mason3263/capstone-kicad/production/OrderFiles/bom-JLCPCB Assembly Order.xls

JLCPCB BOM Tool - BOM Matching
BOM name：bom-JLCPCB Assembly Order.xlsx |  |  | Download Time：2026-02-20 00:51:47 |  |  |  | * Our matching results are updated in real-time, but stock and prices may change. If it's been over 24 hours, please re-match before placing your order.
PCB Assembled Qty：5 |  |  | Est. Total Price：26.3321
Your BOM |  |  |  |  | Matched Parts |  |  |  |  |  |  | Order Information
Top Designator | Bottom Designator | Comment | Footprint | JLCPCB Part # | Matches | Part # | Manufacturer | Footprint | Description | Category | Warning | JLCPCB Part # | Product link | Lib Type | Qty | Source | Total Price ($)
AE1 |  | Antenna | Johanson_2450AT18x100 |  | Select by Customer | 2450AT18A100E | Johanson Dielectrics | 1206 | -40℃~+125℃ 0.5dBi 1.3mm 1.6mm 2.4GHz 2W 3.2mm 50Ω SMA 1206 Antennas ROHS | Antennas |  | C89334 | https://jlcpcb.com/partdetail/JohansonDielectrics-2450AT18A100E/C89334 | Extended | 5 | 5 JLCPCB | 2.884
C1,C10,C2,C20,C21,C3,C5,C7,C8,C9 | C17 | 100nF | 0603 |  | Select by System | CC0603KRX7R9BB104 | YAGEO | 0603 | 100nF 50V X7R ±10% 0603 Multilayer Ceramic Capacitors MLCC - SMD/SMT ROHS | Multilayer Ceramic Capacitors MLCC - SMD/SMT |  | C14663 | https://jlcpcb.com/partdetail/YAGEO-CC0603KRX7R9BB104/C14663 | Basic | 50 | 50 JLCPCB | 0.13
C4,C6 |  | 22uF | 0603 |  | Select by System | CL10A226MQ8NRNC | Samsung Electro-Mechanics | 0603 | 22uF 6.3V X5R ±20% 0603 Multilayer Ceramic Capacitors MLCC - SMD/SMT ROHS | Multilayer Ceramic Capacitors MLCC - SMD/SMT |  | C59461 | https://jlcpcb.com/partdetail/60514-CL10A226MQ8NRNC/C59461 | Basic | 10 | 10 JLCPCB | 0.094
C11,C12,C13,C14 |  | 10pF | 0603 |  | Select by System | CL10C100JB8NNNC | Samsung Electro-Mechanics | 0603 | 10pF 50V C0G ±5% 0603 Multilayer Ceramic Capacitors MLCC - SMD/SMT ROHS | Multilayer Ceramic Capacitors MLCC - SMD/SMT |  | C1634 | https://jlcpcb.com/partdetail/1986-CL10C100JB8NNNC/C1634 | Basic | 20 | 20 JLCPCB | 0.098
C19 |  | 200nF | 0603 |  | Select by System | 0603B204K160CT | Walsin Tech Corp | 0603 | 16V 200nF X7R ±10% 0603 Multilayer Ceramic Capacitors MLCC - SMD/SMT ROHS | Multilayer Ceramic Capacitors MLCC - SMD/SMT |  | C3833176 | https://jlcpcb.com/partdetail/Walsin_TechCorp-0603B204K160CT/C3833176 | Extended | 20 | 20 JLCPCB | 0.706
C22,C25,C31 |  | 2.2uF | 0603 |  | Select by System | CL10A225KO8NNNC | Samsung Electro-Mechanics | 0603 | 16V 2.2uF X5R ±10% 0603 Multilayer Ceramic Capacitors MLCC - SMD/SMT ROHS | Multilayer Ceramic Capacitors MLCC - SMD/SMT |  | C23630 | https://jlcpcb.com/partdetail/24366-CL10A225KO8NNNC/C23630 | Basic | 15 | 15 JLCPCB | 0.0915
C23,C24 | C15 | 1uF | 0603 |  | Select by System | CL10A105KB8NNNC | Samsung Electro-Mechanics | 0603 | 1uF 50V X5R ±10% 0603 Multilayer Ceramic Capacitors MLCC - SMD/SMT ROHS | Multilayer Ceramic Capacitors MLCC - SMD/SMT |  | C15849 | https://jlcpcb.com/partdetail/16531-CL10A105KB8NNNC/C15849 | Basic | 10 | 10 JLCPCB | 0.056
C26,C28 |  | 47pF | 0603 |  | Select by System | CL10C470JB8NNNC | Samsung Electro-Mechanics | 0603 | 47pF 50V C0G ±5% 0603 Multilayer Ceramic Capacitors MLCC - SMD/SMT ROHS | Multilayer Ceramic Capacitors MLCC - SMD/SMT |  | C1671 | https://jlcpcb.com/partdetail/2023-CL10C470JB8NNNC/C1671 | Basic | 10 | 10 JLCPCB | 0.032
C27,C29 | C16,C18 | 10uF | 0603 |  | Select by System | CL10A106KP8NNNC | Samsung Electro-Mechanics | 0603 | 10V 10uF X5R ±10% 0603 Multilayer Ceramic Capacitors MLCC - SMD/SMT ROHS | Multilayer Ceramic Capacitors MLCC - SMD/SMT |  | C19702 | https://jlcpcb.com/partdetail/20411-CL10A106KP8NNNC/C19702 | Basic | 10 | 10 JLCPCB | 0.065
C30 |  | 4.7uF | 0603 |  | Select by System | CL10A475KO8NNNC | Samsung Electro-Mechanics | 0603 | 16V 4.7uF X5R ±10% 0603 Multilayer Ceramic Capacitors MLCC - SMD/SMT ROHS | Multilayer Ceramic Capacitors MLCC - SMD/SMT |  | C19666 | https://jlcpcb.com/partdetail/20375-CL10A475KO8NNNC/C19666 | Basic | 5 | 5 JLCPCB | 0.0515
C32 |  | 1pF | 0603 |  | Select by System | 0603CG1R0C500NT | FH (Guangdong Fenghua Advanced Tech) | 0603 | 1pF 50V C0G 0603 Multilayer Ceramic Capacitors MLCC - SMD/SMT ROHS | Multilayer Ceramic Capacitors MLCC - SMD/SMT |  | C37117 | https://jlcpcb.com/partdetail/38096-0603CG1R0C500NT/C37117 | Extended | 20 | 20 JLCPCB | 0.072
CX2016FB-1 |  | 48MHz | Crystal_SMD_2016-4Pin_2.0x1.6mm |  | Select by Customer | NX2016SA-48MHZ-EXS00A-CS05517 | NDK | SMD2016-4P | -40℃~+105℃ 40Ω 48MHz 7pF Crystal Oscillator ±10ppm ±40ppm SMD2016-4P Crystals ROHS | Global Sourcing Parts |  | C5186571 | https://jlcpcb.com/partdetail/NDK-NX2016SA_48MHZ_EXS00ACS05517/C5186571 | Extended | 5 | 5 JLCPCB | 1.9595
J1 |  | USBC | MOLEX_USBC_1054500101 |  | Select by Customer | 1054500101 | MOLEX | SMD | -30℃~+85℃ 1 10,000 cycles 24P 30V Black Female Type-C USB 3.2 SMD USB Connectors ROHS | USB Connectors |  | C134092 | https://jlcpcb.com/partdetail/MOLEX-1054500101/C134092 | Extended | 5 | 5 JLCPCB | 5.2695
L1,L2 |  | 2.2uH | 1008 |  | Select by Customer | SWPA252012S2R2MT | Sunlord | 1008 | 1.25A 2.07A 2.2uH 216mΩ ±20% 1008 Power Inductors ROHS | Power Inductors |  | C23894 | https://jlcpcb.com/partdetail/Sunlord-SWPA252012S2R2MT/C23894 | Extended | 14 | 14 JLCPCB | 0.6356
L3 |  | 3.9nH | 0603 |  | Select by System | SDCL1608C3N9STDF | Sunlord | 0603 | 10@100MHz 160mΩ 3.9nH 500mA 6GHz Multilayer inductor 0603 Inductors (SMD) ROHS | Inductors (SMD) |  | C13818 | https://jlcpcb.com/partdetail/Sunlord-SDCL1608C3N9STDF/C13818 | Extended | 20 | 20 JLCPCB | 0.27
L4 |  | 2.7nH | 0603 |  | Select by System | SCC1608C2N7SSP | Sunltech Tech | 0603 | 2.7nH 200mΩ 500mA 6GHz 8@100MHz Multilayer inductor 0603 Inductors (SMD) ROHS | Inductors (SMD) |  | C412027 | https://jlcpcb.com/partdetail/SunltechTech-SCC1608C2N7SSP/C412027 | Extended | 20 | 20 JLCPCB | 0.244
NX2012SA-1 |  | 32.768kHz | Crystal_SMD_2012-2Pin_2.0x1.2mm |  | Select by Customer | NX2012SA-32.768KHZ-STD-MUB-2 | NDK | SMD2012-2P | -40℃~+85℃ 32.768kHz Crystal Oscillator SMD2012-2P Crystals ROHS | Crystals |  | C891748 | https://jlcpcb.com/partdetail/NDK-NX2012SA_32_768KHZ_STD_MUB2/C891748 | Extended | 5 | 5 JLCPCB | 1.845
R1 |  | 100k | 0603 |  | Unconfirmed | 0603WAF1003T5E | UNI-ROYAL(Uniroyal Elec) | 0603 | -55℃~+155℃ 100kΩ 100mW 75V Thick Film Resistor ±1% ±100ppm/℃ 0603 Chip Resistor - Surface Mount ROHS | Chip Resistor - Surface Mount | 1.The comment (0603WAF1003T5E) of this part does not match the one (100k) provided in your BOM. Please confirm; | C25803 | https://jlcpcb.com/partdetail/26546-0603WAF1003T5E/C25803 | Basic | 5 | 5 JLCPCB | 0.0055
R2 |  | 680k | 0603 |  | Unconfirmed | 0603WAF6803T5E | UNI-ROYAL(Uniroyal Elec) | 0603 | -55℃~+155℃ 100mW 680kΩ 75V Thick Film Resistor ±1% ±100ppm/℃ 0603 Chip Resistor - Surface Mount ROHS | Chip Resistor - Surface Mount | 1.The comment (0603WAF6803T5E) of this part does not match the one (680k) provided in your BOM. Please confirm; | C25822 | https://jlcpcb.com/partdetail/26565-0603WAF6803T5E/C25822 | Extended | 20 | 20 JLCPCB | 0.024
R3,R5 |  | 150k | 0603 |  | Unconfirmed | 0603WAF1503T5E | UNI-ROYAL(Uniroyal Elec) | 0603 | -55℃~+155℃ 100mW 150kΩ 75V Thick Film Resistor ±1% ±100ppm/℃ 0603 Chip Resistor - Surface Mount ROHS | Chip Resistor - Surface Mount | 1.The comment (0603WAF1503T5E) of this part does not match the one (150k) provided in your BOM. Please confirm; | C22807 | https://jlcpcb.com/partdetail/23534-0603WAF1503T5E/C22807 | Basic | 10 | 10 JLCPCB | 0.013
R4 |  | 350k | 0603 |  | Unconfirmed | AR03FTDX3503N | Viking Tech | 0603 | -55℃~+155℃ 100mW 350kΩ Thin Film Resistor ±1% ±50ppm/℃ 0603 Chip Resistor - Surface Mount ROHS | Chip Resistor - Surface Mount | 1.The comment (AR03FTDX3503N) of this part does not match the one (350k) provided in your BOM. Please confirm; | C3013581 | https://jlcpcb.com/partdetail/VikingTech-AR03FTDX3503N/C3013581 | Extended | 20 | 20 JLCPCB | 0.186
R6 |  | 240k | 0603 |  | Unconfirmed | 0603WAF2403T5E | UNI-ROYAL(Uniroyal Elec) | 0603 | -55℃~+155℃ 100mW 240kΩ 75V Thick Film Resistor ±1% ±100ppm/℃ 0603 Chip Resistor - Surface Mount ROHS | Chip Resistor - Surface Mount | 1.The comment (0603WAF2403T5E) of this part does not match the one (240k) provided in your BOM. Please confirm; | C4197 | https://jlcpcb.com/partdetail/4604-0603WAF2403T5E/C4197 | Extended | 20 | 20 JLCPCB | 0.024
R8 |  | 27.4k | 0603 |  | Unconfirmed | FRC0603F2742TS | FOJAN | 0603 | -55℃~+155℃ 100mW 27.4kΩ 75V Thick Film Resistor ±1% ±100ppm/℃ 0603 Chip Resistor - Surface Mount ROHS | Chip Resistor - Surface Mount | 1.The comment (FRC0603F2742TS) of this part does not match the one (27.4k) provided in your BOM. Please confirm; | C2933186 | https://jlcpcb.com/partdetail/FOJAN-FRC0603F2742TS/C2933186 | Extended | 20 | 20 JLCPCB | 0.026
R9 |  | 1k | 0603 |  | Unconfirmed | 0603WAF1001T5E | UNI-ROYAL(Uniroyal Elec) | 0603 | -55℃~+155℃ 100mW 1kΩ 75V Thick Film Resistor ±1% ±100ppm/℃ 0603 Chip Resistor - Surface Mount ROHS | Chip Resistor - Surface Mount | 1.The comment (0603WAF1001T5E) of this part does not match the one (1k) provided in your BOM. Please confirm; | C21190 | https://jlcpcb.com/partdetail/21904-0603WAF1001T5E/C21190 | Basic | 5 | 5 JLCPCB | 0.006
R10 |  | 50 | 0603 |  | Unconfirmed | RT0603BRE0750RL | YAGEO | 0603 | -55℃~+155℃ 100mW 50Ω 75V Thin Film Resistor ±0.1% ±50ppm/℃ 0603 Chip Resistor - Surface Mount ROHS | Chip Resistor - Surface Mount | 1.The comment (RT0603BRE0750RL) of this part does not match the one (50) provided in your BOM. Please confirm; | C849792 | https://jlcpcb.com/partdetail/YAGEO-RT0603BRE0750RL/C849792 | Extended | 20 | 20 JLCPCB | 0.554
R11,R13,R7 |  | 10k | 0603 |  | Unconfirmed | 0603WAF1002T5E | UNI-ROYAL(Uniroyal Elec) | 0603 | -55℃~+155℃ 100mW 10kΩ 75V Thick Film Resistor ±1% ±100ppm/℃ 0603 Chip Resistor - Surface Mount ROHS | Chip Resistor - Surface Mount | 1.The comment (0603WAF1002T5E) of this part does not match the one (10k) provided in your BOM. Please confirm; | C25804 | https://jlcpcb.com/partdetail/26547-0603WAF1002T5E/C25804 | Basic | 15 | 15 JLCPCB | 0.018
R12 |  | 300k | 0603 |  | Unconfirmed | 0603WAF3003T5E | UNI-ROYAL(Uniroyal Elec) | 0603 | -55℃~+155℃ 100mW 300kΩ 75V Thick Film Resistor ±1% ±100ppm/℃ 0603 Chip Resistor - Surface Mount ROHS | Chip Resistor - Surface Mount | 1.The comment (0603WAF3003T5E) of this part does not match the one (300k) provided in your BOM. Please confirm; | C23024 | https://jlcpcb.com/partdetail/23751-0603WAF3003T5E/C23024 | Basic | 5 | 5 JLCPCB | 0.0065
U3 |  | BQ25176JDSGR | BQ25176 |  | Select by System | BQ25176JDSGR | Texas Instruments | WSON-8-EP(2x2) | -40℃~+125℃ 1 3V~25V 800mA WSON-8-EP(2x2) Battery Management ROHS | Battery Management |  | C22407142 | https://jlcpcb.com/partdetail/TexasInstruments-BQ25176JDSGR/C22407142 | Extended | 5 | 5 JLCPCB | 5.064
U5 |  | BQ27427YZFR | BQ27427 |  | Select by System | BQ27427YZFR | Texas Instruments | DSBGA-9 | -40℃~+85℃ 1 2.45V~4.5V 50uA I2C Lithium Battery Monitoring IC Support DSBGA-9 Battery Management ROHS | Battery Management |  | C6075475 | https://jlcpcb.com/partdetail/TexasInstruments-BQ27427YZFR/C6075475 | Extended | 5 | 5 JLCPCB | 5.9015
U2 |  | ADXL366BCCZ-RL7 | ADXL366BCCZ-RL7 |  | Select by System | ADXL366BCCZ-RL7 | Analog Devices | - | - LCDH ROHS |  |  | C48940637 | https://jlcpcb.com/partdetail/AnalogDevices-ADXL366BCCZRL7/C48940637 | Extended | 5 | 0 JLCPCB | 0
U4 |  | TPS650531RGER | TPS650531 |  | Select by System | TPS650531RGER | Texas Instruments | VQFN-24-EP(4x4) | -40℃~+85℃ 2.25MHz 2.5V~6V Buck Buck Built-in VQFN-24-EP(4x4) Power Management - Specialized ROHS | DC-DC Converters |  | C527526 | https://jlcpcb.com/partdetail/TexasInstruments-TPS650531RGER/C527526 | Extended | 5 | 0 JLCPCB | 0
J2 |  | Conn_01x02_Pin | PinHeader_1x02_P2.54mm_Vertical |  | No matches | No Part Selected
J3 |  | Conn_01x05 | PinHeader_1x05_P2.54mm_Vertical |  | No matches | No Part Selected
MCU1 |  | CC2674R106T0RGZR | CC2647R106T0RGZR |  | No matches | No Part Selected
P1,P2 |  |  |  |  | No matches | No Part Selected
