mason3263/capstone-kicad/models/FC-135.step

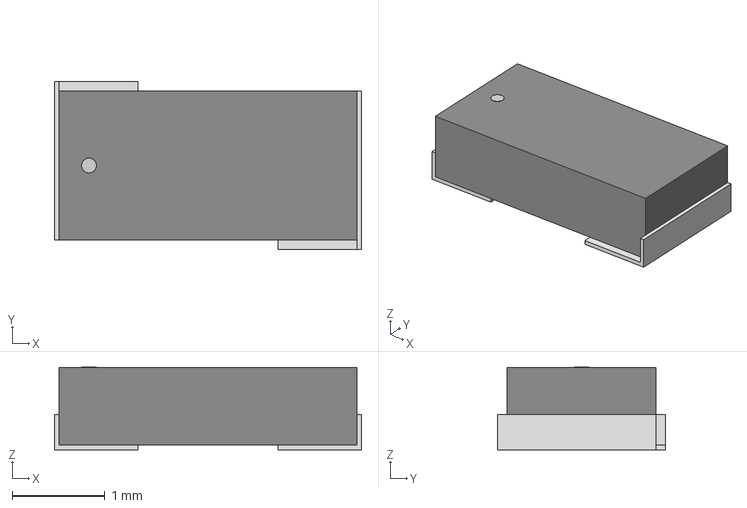
[picture p1: CAD file, 2025-11-21]
models/FC-135.step
3.30 x 1.80 x 0.892 mm
