mason3263/capstone-kicad/models/TSX-3225-24.0000MF15X-AC3.step

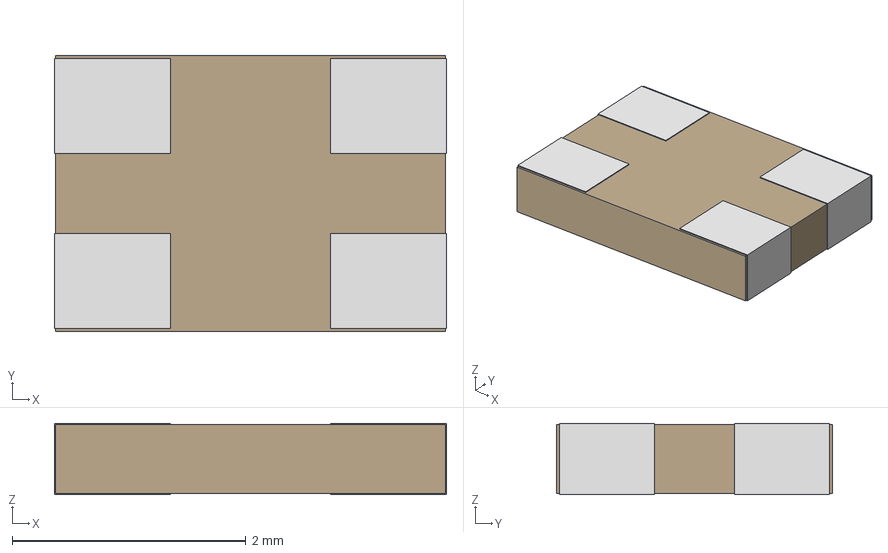
[picture p2: CAD file, 2025-11-21]
models/TSX-3225-24.0000MF15X-AC3.step
3.35 x 2.36 x 0.61 mm
