mason3263/capstone-kicad/health_monitor.kicad_pcb

## KiCad design health_monitor.kicad_pcb (2026-02-24)

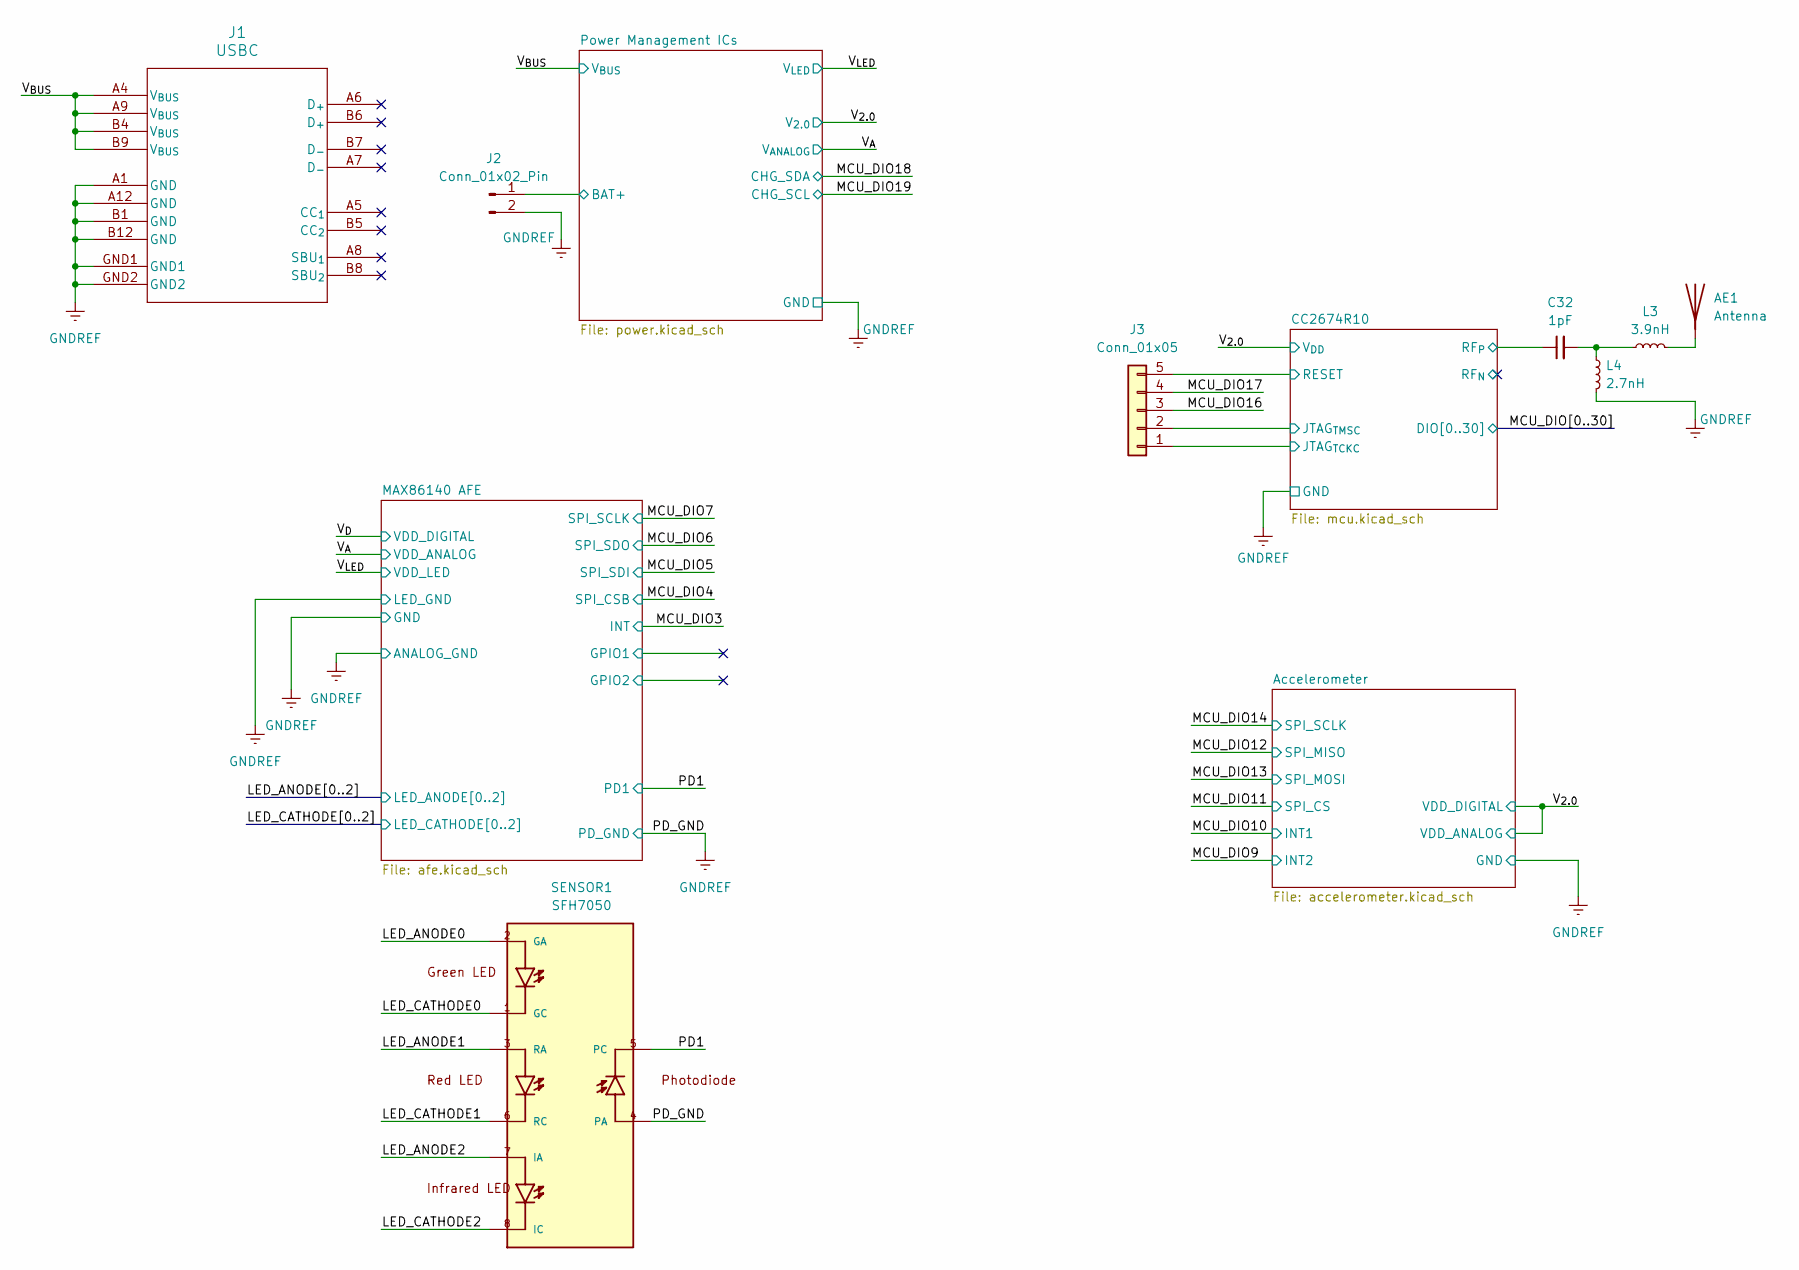
[picture p3: schematic health_monitor.kicad_sch, Wearable Vital Monitor]

Parts:
AE1: Antenna; Johanson_2450AT18x100; LCSC PN C89334
C32: 1pF; C_0603_1608Metric
J1: USBC; MOLEX_USBC_1054500101; LCSC PN C134092
J2: Conn_01x02_Pin; PinHeader_1x02_P2.54mm_Vertical
J3: Conn_01x05; PinHeader_1x05_P2.54mm_Vertical
L3: 3.9nH; L_0603_1608Metric
L4: 2.7nH; L_0603_1608Metric
SENSOR1: SFH7050; SFH 7050A_OSM

Connections:
/CC2674R10/JTAG_{TCKC}: J3.1; also elsewhere on the board
/CC2674R10/JTAG_{TMSC}: J3.2; also elsewhere on the board
/CC2674R10/RESET: J3.5; also elsewhere on the board
/CC2674R10/RF_{P}: C32.1; also elsewhere on the board
/LED_CATHODE0: SENSOR1.1 (GC); also elsewhere on the board
/LED_CATHODE1: SENSOR1.6 (RC); also elsewhere on the board
/LED_CATHODE2: SENSOR1.8 (IC); also elsewhere on the board
/MCU_DIO16: J3.3; also elsewhere on the board
/MCU_DIO17: J3.4; also elsewhere on the board
/PD1: SENSOR1.5 (PC); also elsewhere on the board
/Power Management ICs/BAT+: J2.1; also elsewhere on the board
/V_{BUS}: J1.A4 (V_{BUS}), J1.A9 (V_{BUS}), J1.B4 (V_{BUS}), J1.B9 (V_{BUS}); also elsewhere on the board
/V_{LED}: SENSOR1.2 (GA), SENSOR1.3 (RA), SENSOR1.7 (IA); also elsewhere on the board
GNDREF: J1.A1 (GND), J1.A12 (GND), J1.B1 (GND), J1.B12 (GND), J1.GND1, J1.GND2, J2.2, L4.2, SENSOR1.4 (PA); also elsewhere on the board
unnamed: AE1.1 (A), L3.2
unnamed: C32.2, L3.1, L4.1

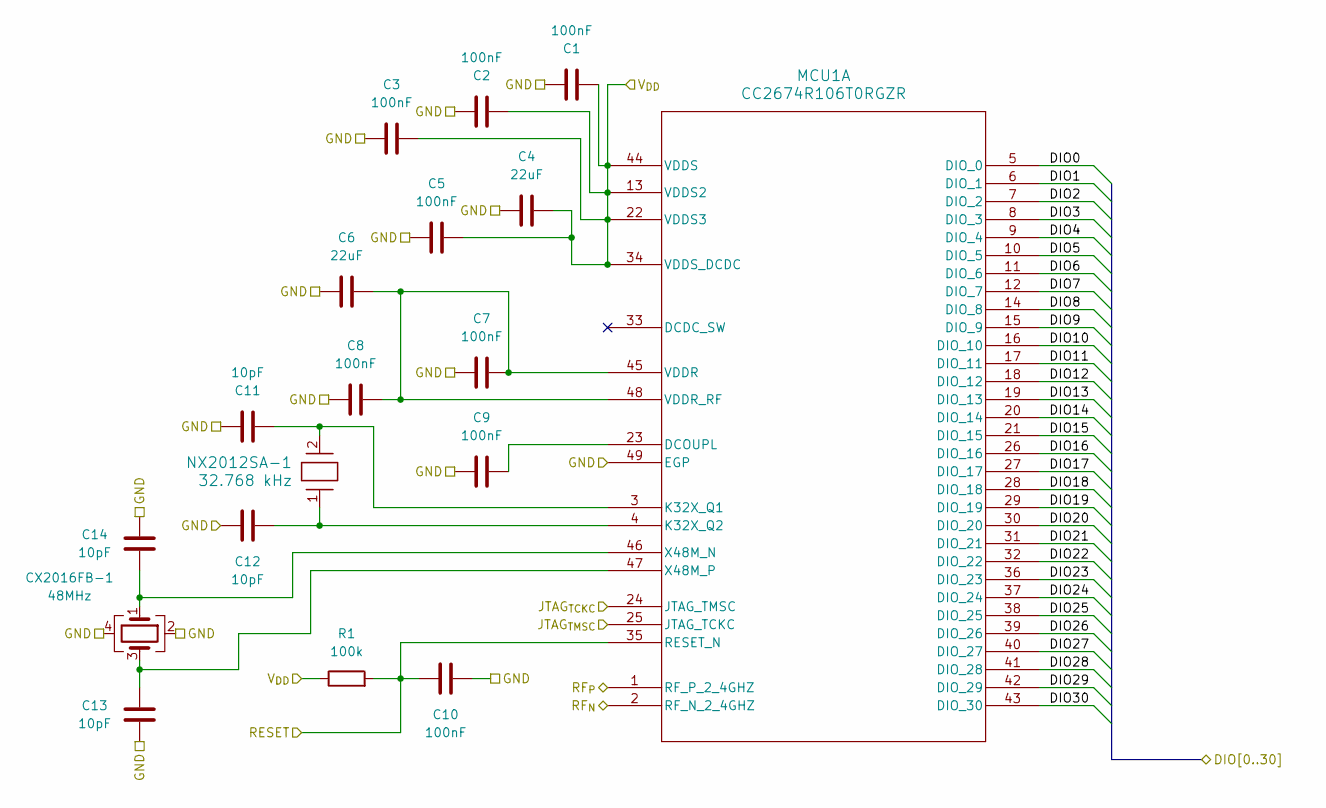
[picture p4: schematic mcu.kicad_sch, CC2674R10 Microcontroller]

Parts:
C1, C2, C3, C5, C7, C8, C9: 100nF; C_0603_1608Metric
C4, C6: 22uF; C_0603_1608Metric
C10: 100nF; C_0603_1608Metric_Pad1.08x0.95mm_HandSolder
C11, C12, C13, C14: 10pF; C_0603_1608Metric
CX2016FB-1: 48MHz; Crystal_SMD_2016-4Pin_2.0x1.6mm; LCSC PN C5186571
MCU1: CC2674R106T0RGZR; CC2647R106T0RGZR
NX2012SA-1: 32.768 kHz; Crystal_SMD_2012-2Pin_2.0x1.2mm; LCSC PN C891748
R1: 100k; R_0603_1608Metric

Connections:
/CC2674R10/JTAG_{TCKC}: MCU1.24 (JTAG_TMSC); also elsewhere on the board
/CC2674R10/JTAG_{TMSC}: MCU1.25 (JTAG_TCKC); also elsewhere on the board
/CC2674R10/RESET: C10.1, MCU1.35 (RESET_N), R1.2; also elsewhere on the board
/CC2674R10/RF_{N}: MCU1.2 (RF_N_2_4GHZ)
/CC2674R10/RF_{P}: MCU1.1 (RF_P_2_4GHZ); also elsewhere on the board
/MCU_DIO0: MCU1.5 (DIO_0)
/MCU_DIO1: MCU1.6 (DIO_1)
/MCU_DIO2: MCU1.7 (DIO_2)
/MCU_DIO3: MCU1.8 (DIO_3); also elsewhere on the board
/MCU_DIO4: MCU1.9 (DIO_4); also elsewhere on the board
/MCU_DIO5: MCU1.10 (DIO_5); also elsewhere on the board
/MCU_DIO6: MCU1.11 (DIO_6); also elsewhere on the board
/MCU_DIO7: MCU1.12 (DIO_7); also elsewhere on the board
/MCU_DIO8: MCU1.14 (DIO_8)
/MCU_DIO9: MCU1.15 (DIO_9); also elsewhere on the board
/MCU_DIO10: MCU1.16 (DIO_10); also elsewhere on the board
/MCU_DIO11: MCU1.17 (DIO_11); also elsewhere on the board
/MCU_DIO12: MCU1.18 (DIO_12); also elsewhere on the board
/MCU_DIO13: MCU1.19 (DIO_13); also elsewhere on the board
/MCU_DIO14: MCU1.20 (DIO_14); also elsewhere on the board
/MCU_DIO15: MCU1.21 (DIO_15)
/MCU_DIO16: MCU1.26 (DIO_16); also elsewhere on the board
/MCU_DIO17: MCU1.27 (DIO_17); also elsewhere on the board
/MCU_DIO18: MCU1.28 (DIO_18); also elsewhere on the board
/MCU_DIO19: MCU1.29 (DIO_19); also elsewhere on the board
/MCU_DIO20: MCU1.30 (DIO_20)
/MCU_DIO21: MCU1.31 (DIO_21)
/MCU_DIO22: MCU1.32 (DIO_22)
/MCU_DIO23: MCU1.36 (DIO_23)
/MCU_DIO24: MCU1.37 (DIO_24)
/MCU_DIO25: MCU1.38 (DIO_25)
/MCU_DIO26: MCU1.39 (DIO_26)
/MCU_DIO27: MCU1.40 (DIO_27)
/MCU_DIO28: MCU1.41 (DIO_28)
/MCU_DIO29: MCU1.42 (DIO_29)
/MCU_DIO30: MCU1.43 (DIO_30)
/V_{2.0}: C1.1, C2.1, C3.1, C4.2, C5.1, MCU1.13 (VDDS2), MCU1.22 (VDDS3), MCU1.34 (VDDS_DCDC), MCU1.44 (VDDS), R1.1; also elsewhere on the board
GNDREF: C1.2, C2.2, C3.2, C4.1, C5.2, C6.1, C7.2, C8.2, C9.2, C10.2, C11.2, C12.1, C13.2, C14.1, CX2016FB-1.2, CX2016FB-1.4, MCU1.49 (EGP); also elsewhere on the board
unnamed: C9.1, MCU1.23 (DCOUPL)
unnamed: C11.1, MCU1.3 (K32X_Q1), NX2012SA-1.2
unnamed: C12.2, MCU1.4 (K32X_Q2), NX2012SA-1.1
unnamed: C6.2, C7.1, C8.1, MCU1.45 (VDDR), MCU1.48 (VDDR_RF)
unnamed: C14.2, CX2016FB-1.1, MCU1.46 (X48M_N)
unnamed: C13.1, CX2016FB-1.3, MCU1.47 (X48M_P)

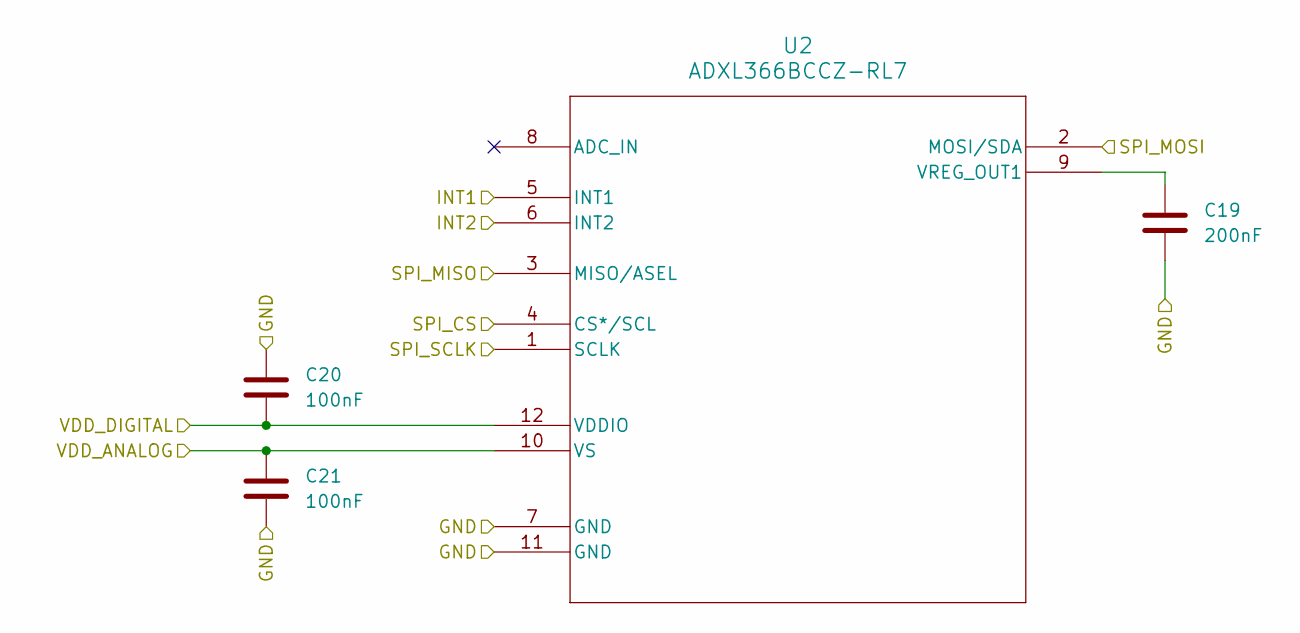
[picture p5: schematic accelerometer.kicad_sch, ADCL366 Accelerometer]

Parts:
C19: 200nF; C_0603_1608Metric
C20, C21: 100nF; C_0603_1608Metric
U2: ADXL366BCCZ-RL7

Connections:
/MCU_DIO9: U2.6 (INT2); also elsewhere on the board
/MCU_DIO10: U2.5 (INT1); also elsewhere on the board
/MCU_DIO11: U2.4 (CS*/SCL); also elsewhere on the board
/MCU_DIO12: U2.3 (MISO/ASEL); also elsewhere on the board
/MCU_DIO13: U2.2 (MOSI/SDA); also elsewhere on the board
/MCU_DIO14: U2.1 (SCLK); also elsewhere on the board
/V_{2.0}: C20.2, C21.1, U2.10 (VS), U2.12 (VDDIO); also elsewhere on the board
GNDREF: C19.2, C20.1, C21.2, U2.7 (GND), U2.11 (GND); also elsewhere on the board
unnamed: C19.1, U2.9 (VREG_OUT1)

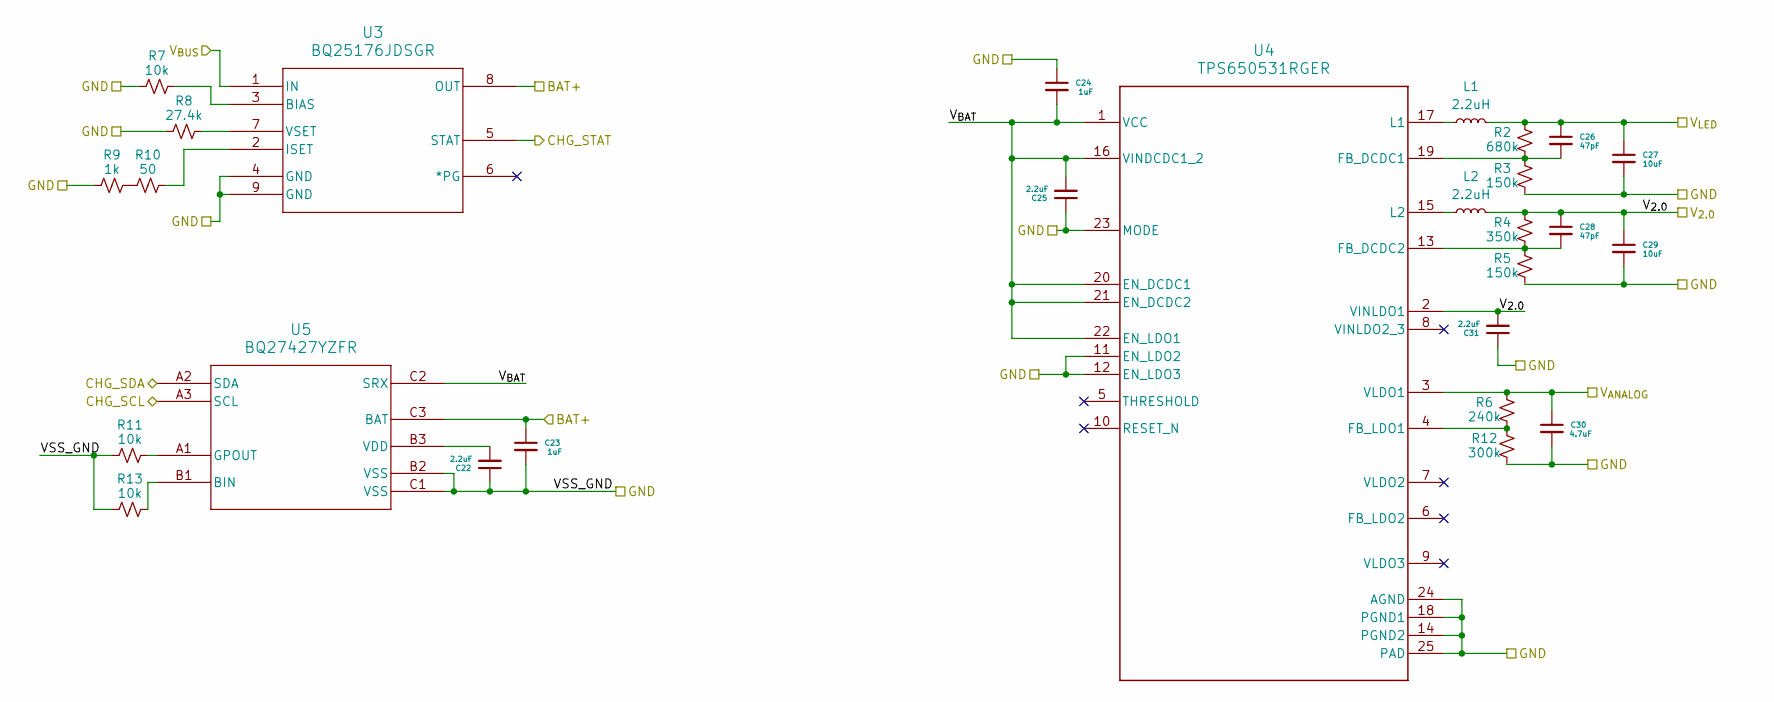
[picture p6: schematic power.kicad_sch, MAX20356 Power Management IC]

Parts:
C22, C25, C31: 2.2uF; C_0603_1608Metric
C23, C24: 1uF; C_0603_1608Metric
C26, C28: 47pF; C_0603_1608Metric
C27, C29: 10uF; C_0603_1608Metric
C30: 4.7uF; C_0603_1608Metric
L1, L2: 2.2uH; L_1008_2520Metric; LCSC PN C23894
R2: 680k; R_0603_1608Metric
R3, R5: 150k; R_0603_1608Metric
R4: 350k; R_0603_1608Metric
R6: 240k; R_0603_1608Metric
R7, R11, R13: 10k; R_0603_1608Metric
R8: 27.4k; R_0603_1608Metric
R9: 1k; R_0603_1608Metric
R10: 50; R_0603_1608Metric
R12: 300k; R_0603_1608Metric
U3: BQ25176JDSGR; BQ25176; LCSC PN C22407142
U4: TPS650531RGER; TPS650531; LCSC PN C527526
U5: BQ27427YZFR; BQ27427

Connections:
/MCU_DIO18: U5.A2 (SDA); also elsewhere on the board
/MCU_DIO19: U5.A3 (SCL); also elsewhere on the board
/Power Management ICs/BAT+: C23.1, U3.8 (OUT), U5.C3 (BAT); also elsewhere on the board
/Power Management ICs/CHG_STAT: U3.5 (STAT)
/Power Management ICs/V_{BAT}: C24.2, C25.2, U4.1 (VCC), U4.16 (VINDCDC1_2), U4.20 (EN_DCDC1), U4.21 (EN_DCDC2), U4.22 (EN_LDO1), U5.C2 (SRX)
/V_{2.0}: C28.1, C29.1, C31.2, L2.2, R4.2, U4.2 (VINLDO1); also elsewhere on the board
/V_{A}: C30.1, R6.2, U4.3 (VLDO1); also elsewhere on the board
/V_{BUS}: U3.1 (IN); also elsewhere on the board
/V_{LED}: C26.1, C27.1, L1.2, R2.2; also elsewhere on the board
GNDREF: C22.1, C23.2, C24.1, C25.1, C27.2, C29.2, C30.2, C31.1, R3.1, R5.1, R7.1, R8.1, R9.1, R11.1, R12.1, R13.1, U3.4 (GND), U3.9 (GND), U4.11 (EN_LDO2), U4.12 (EN_LDO3), U4.14 (PGND2), U4.18 (PGND1), U4.23 (MODE), U4.24 (AGND), U4.25 (PAD), U4.V1, U4.V2, U4.V3, U4.V4, U4.V5, U5.B2 (VSS), U5.C1 (VSS); also elsewhere on the board
unnamed: R9.2, R10.1
unnamed: R7.2, U3.3 (BIAS)
unnamed: R10.2, U3.2 (ISET)
unnamed: R8.2, U3.7 (VSET)
unnamed: C26.2, R2.1, R3.2, U4.19 (FB_DCDC1)
unnamed: C28.2, R4.1, R5.2, U4.13 (FB_DCDC2)
unnamed: R6.1, R12.2, U4.4 (FB_LDO1)
unnamed: L1.1, U4.17 (L1)
unnamed: L2.1, U4.15 (L2)
unnamed: R13.2, U5.B1 (BIN)
unnamed: R11.2, U5.A1 (GPOUT)
unnamed: C22.2, U5.B3 (VDD)

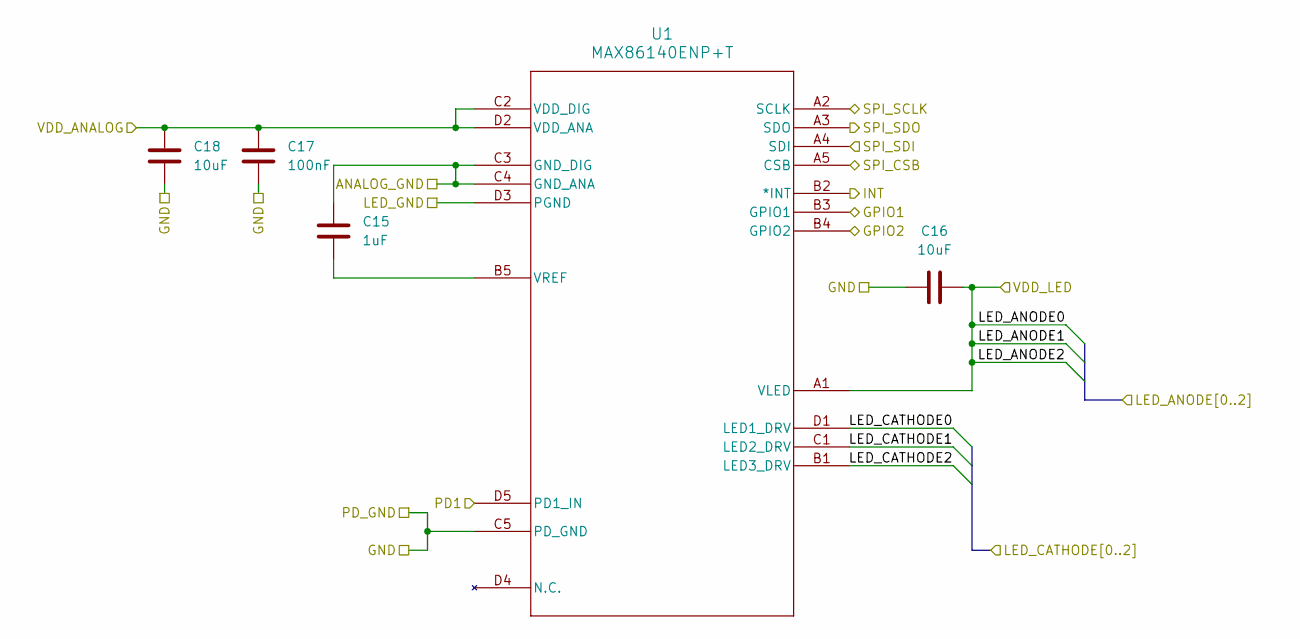
[picture p7: schematic afe.kicad_sch, MAX86140 Analog Front-End]

Parts:
C15: 1uF; C_0603_1608Metric
C16, C18: 10uF; C_0603_1608Metric
C17: 100nF; C_0603_1608Metric
U1: MAX86140ENP+T

Connections:
/LED_CATHODE0: U1.D1 (LED1_DRV); also elsewhere on the board
/LED_CATHODE1: U1.C1 (LED2_DRV); also elsewhere on the board
/LED_CATHODE2: U1.B1 (LED3_DRV); also elsewhere on the board
/MAX86140 AFE/GPIO1: U1.B3 (GPIO1)
/MAX86140 AFE/GPIO2: U1.B4 (GPIO2)
/MCU_DIO3: U1.B2 (*INT); also elsewhere on the board
/MCU_DIO4: U1.A5 (CSB); also elsewhere on the board
/MCU_DIO5: U1.A4 (SDI); also elsewhere on the board
/MCU_DIO6: U1.A3 (SDO); also elsewhere on the board
/MCU_DIO7: U1.A2 (SCLK); also elsewhere on the board
/PD1: U1.D5 (PD1_IN); also elsewhere on the board
/V_{A}: C17.1, C18.1, U1.C2 (VDD_DIG), U1.D2 (VDD_ANA); also elsewhere on the board
/V_{LED}: C16.2, U1.A1 (VLED); also elsewhere on the board
GNDREF: C15.1, C16.1, C17.2, C18.2, U1.C3 (GND_DIG), U1.C4 (GND_ANA), U1.C5 (PD_GND), U1.D3 (PGND); also elsewhere on the board
unnamed: C15.2, U1.B5 (VREF)

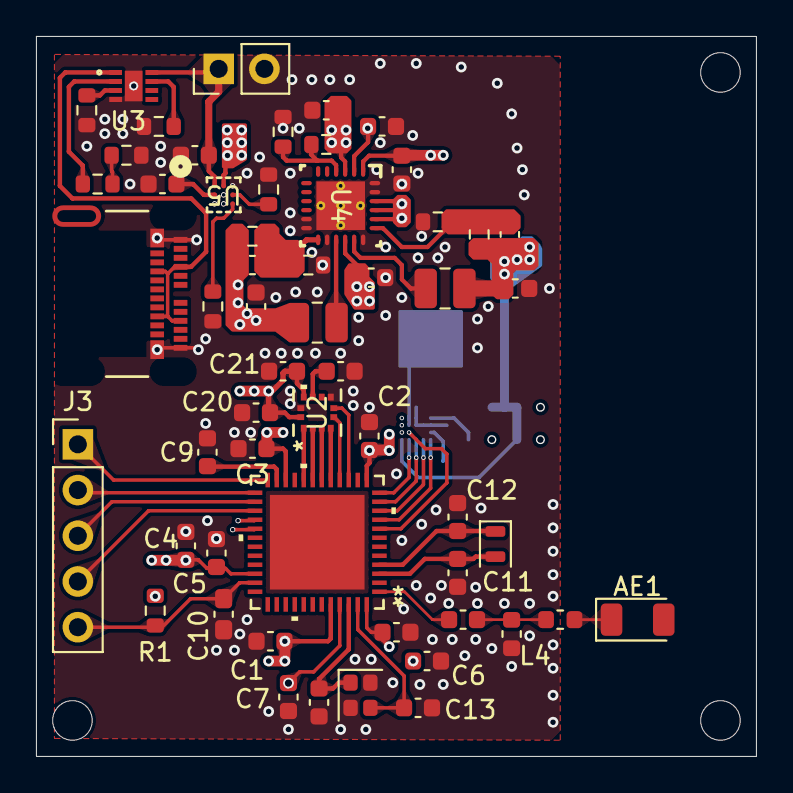
[picture p8: board health_monitor.kicad_pcb from above]

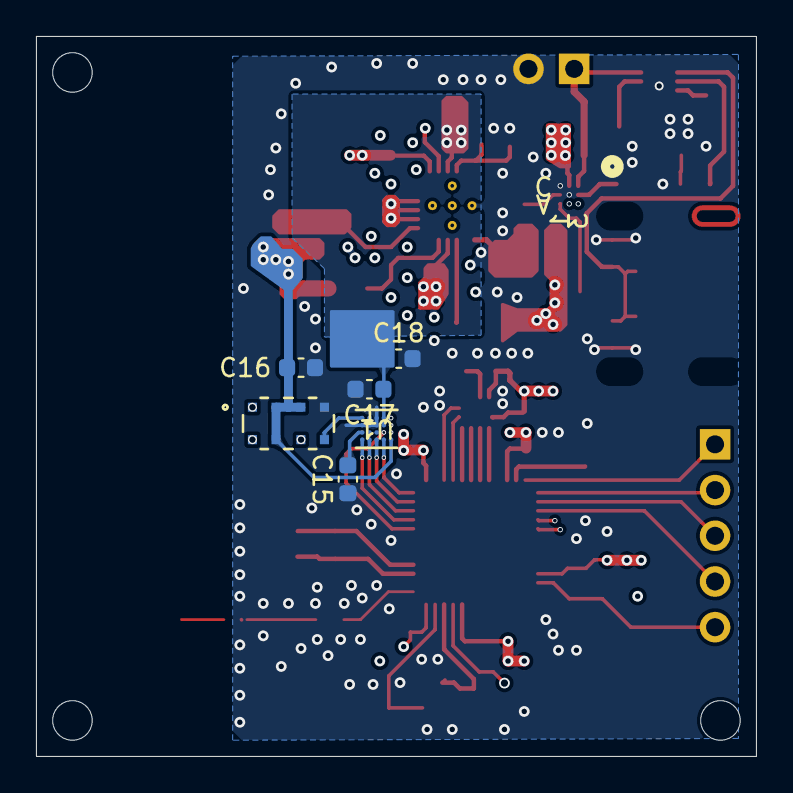
[picture p9: board health_monitor.kicad_pcb from below]

Board: 4 copper layers, 40.0 x 40.0 mm, 65 parts (6 on the bottom side), 52 nets.

Other parts of the board:
P1, P2: (no value)
P3: MountingHole_2.2mm_M2
