mason3263/capstone-kicad/(commit log)

2025-11-21 MCU Submodule done
    [FC-135.step, TSX-3225-24.0000MF15X-AC3.step, afe.kicad_sch, health_monitor.kicad_pcb, health_monitor.kicad_sch, mcu.kicad_sch]
2025-11-25 schematic 90%
    [accelerometer.kicad_sch, afe.kicad_sch, health_monitor.kicad_sch, mcu.kicad_sch, power.kicad_sch]
2025-12-02 General Structure
    [accelerometer.kicad_sch, afe.kicad_sch, health_monitor.kicad_sch, mcu.kicad_sch, power.kicad_sch]
2026-01-15 inital routing
    [accelerometer.kicad_sch, afe.kicad_sch, health_monitor.kicad_pcb, health_monitor.kicad_sch, mcu.kicad_sch, power.kicad_sch]
2026-01-30 schematic mostly finished
    [accelerometer.kicad_sch, afe.kicad_sch, health_monitor.kicad_pcb, health_monitor.kicad_sch, mcu.kicad_sch, power.kicad_sch]
2026-02-17 ready to order
    [accelerometer.kicad_sch, afe.kicad_sch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]
2026-02-19 resize to 0603
    [accelerometer.kicad_sch, health_monitor.kicad_pcb, health_monitor.kicad_sch, mcu.kicad_sch, power.kicad_sch]
2026-02-19 final order
    [bom-JLCPCB Assembly Order.xls, health_monitor.kicad_pcb, health_monitor.kicad_sch, mcu.kicad_sch, power.kicad_sch]
2026-02-24 fix 4am horrors
    [health_monitor.kicad_pcb]
